digixx/VHF-UHF-Modul-Board/README.md

# VHF-UHF-Modul-Board

This board helps to use SA8x8 VHF/UHF transceiver modules in any projects. It supports an adjustable MIC-Amp and Speaker-Amp. You can choose between a classic microphone or digital output of an mikrocontroller. It is 5V friendly and has LEDs for most signals.
