digixx/VHF-UHF-Modul-Board/production/v1.1/components.png

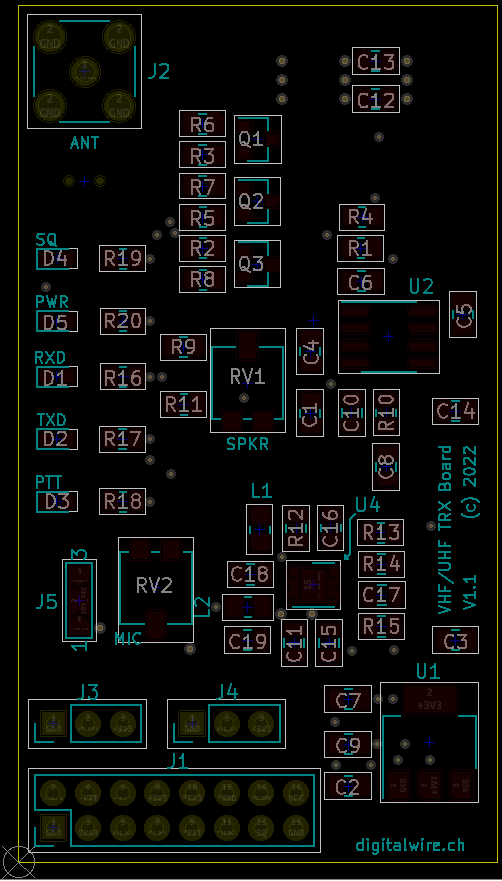
production/v1.1/components.png
