digixx/VHF-UHF-Modul-Board/production/v1.1/schemata.pdf

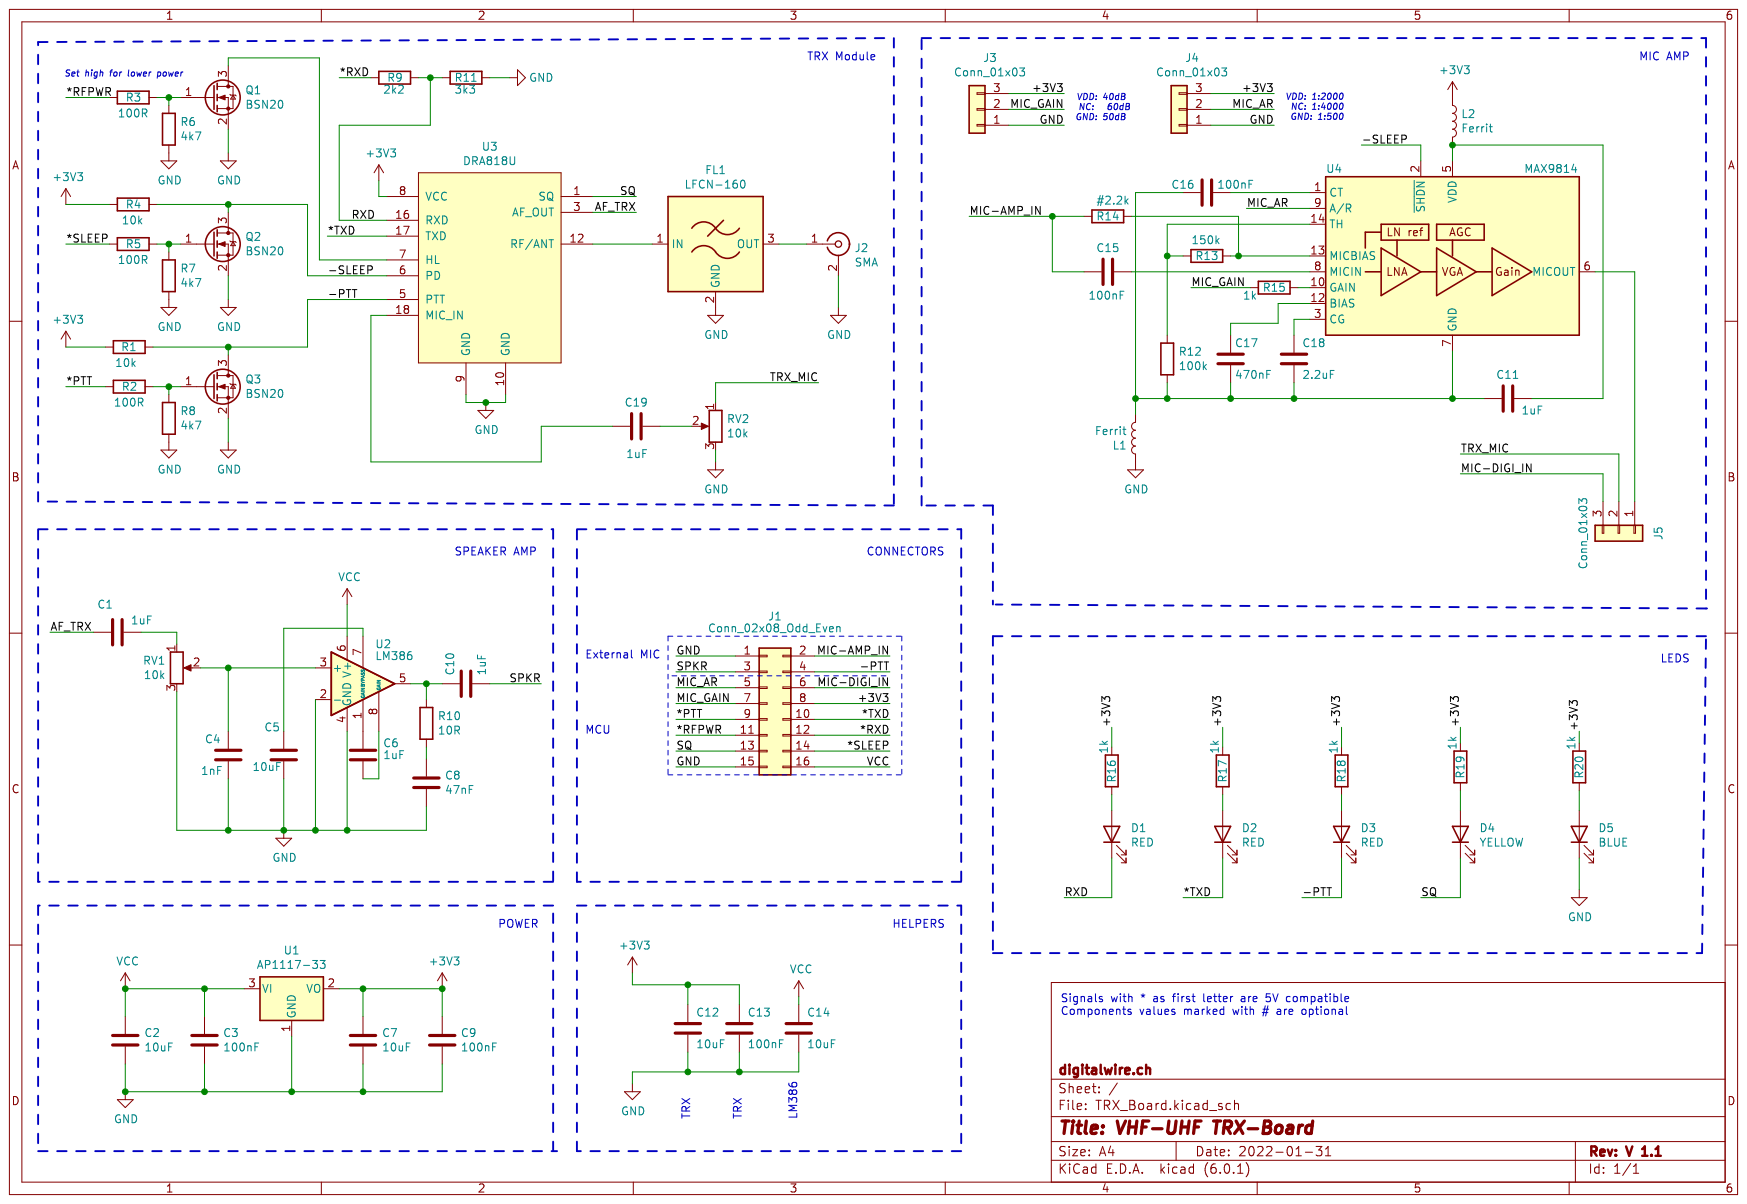
[picture p2: page 1]
