digixx/VHF-UHF-Modul-Board/production/v1,0a/schemata.pdf

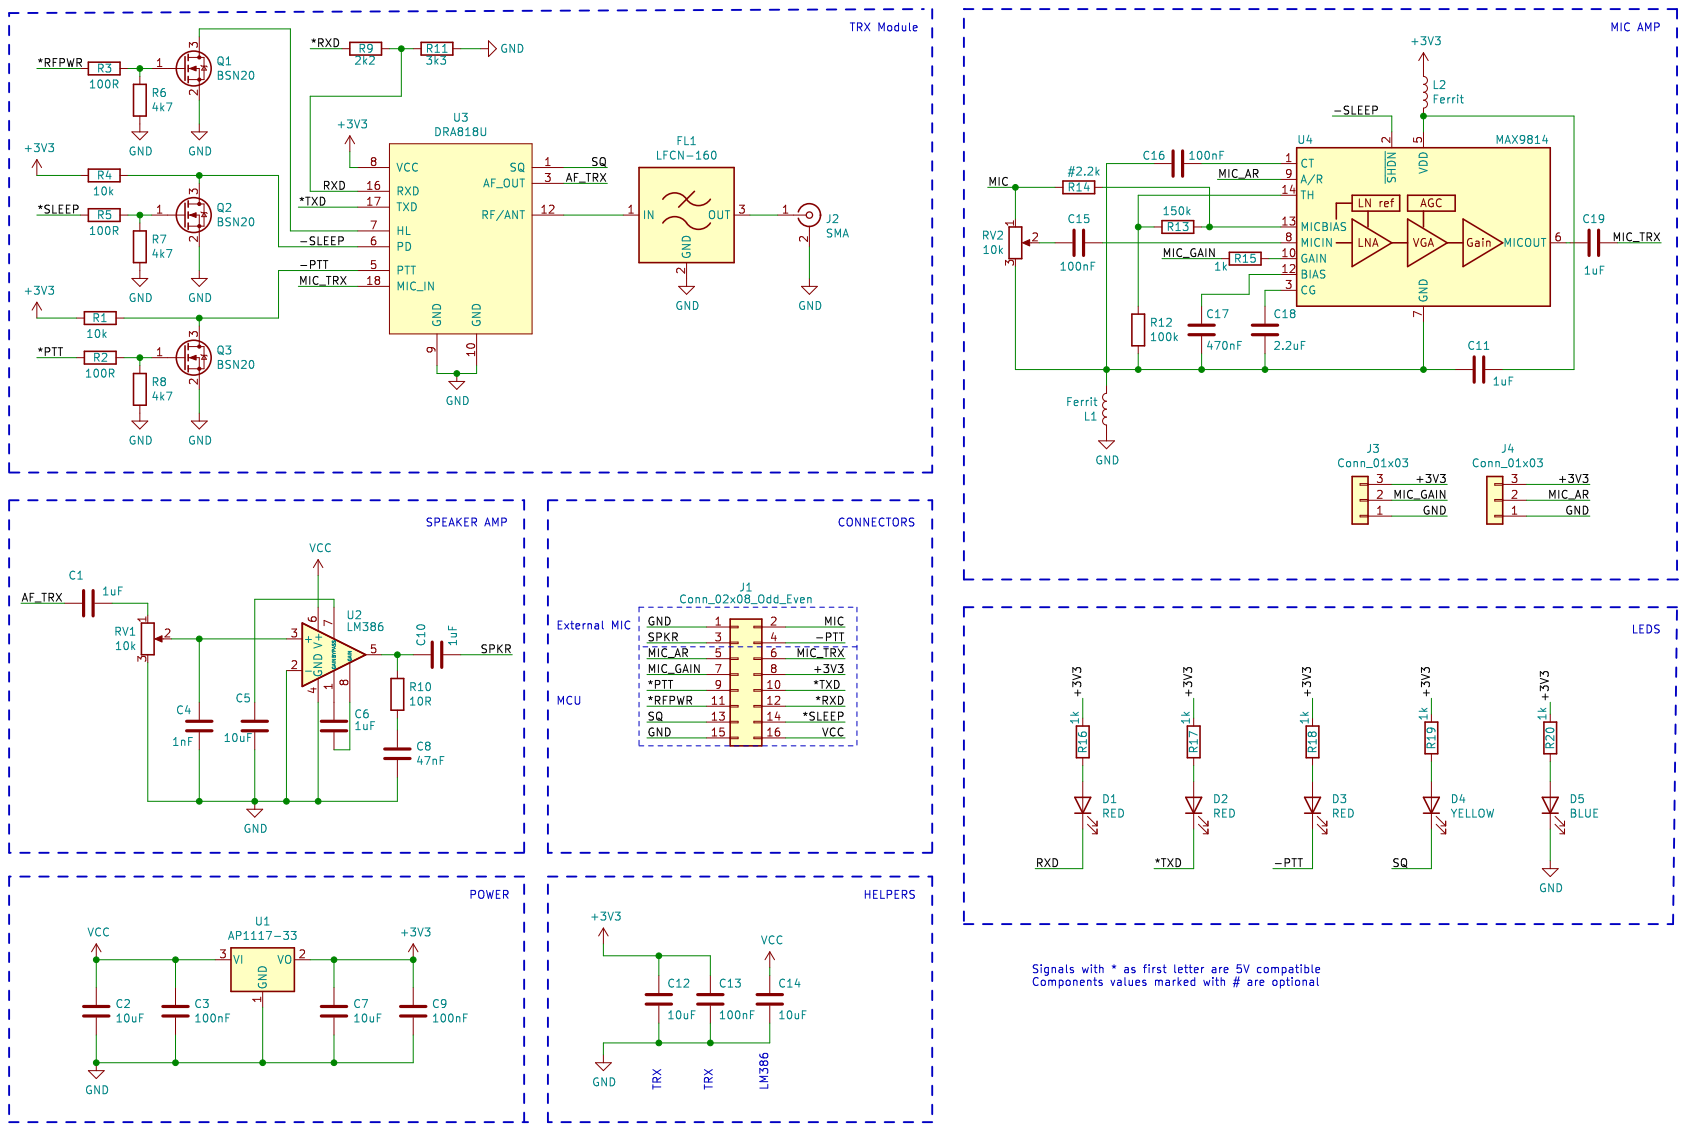
[picture p8: page 1]
