digixx/VHF-UHF-Modul-Board/hardware/TRX_Board.kicad_pcb

## KiCad design hardware/TRX_Board.kicad_pcb (2022-02-01)

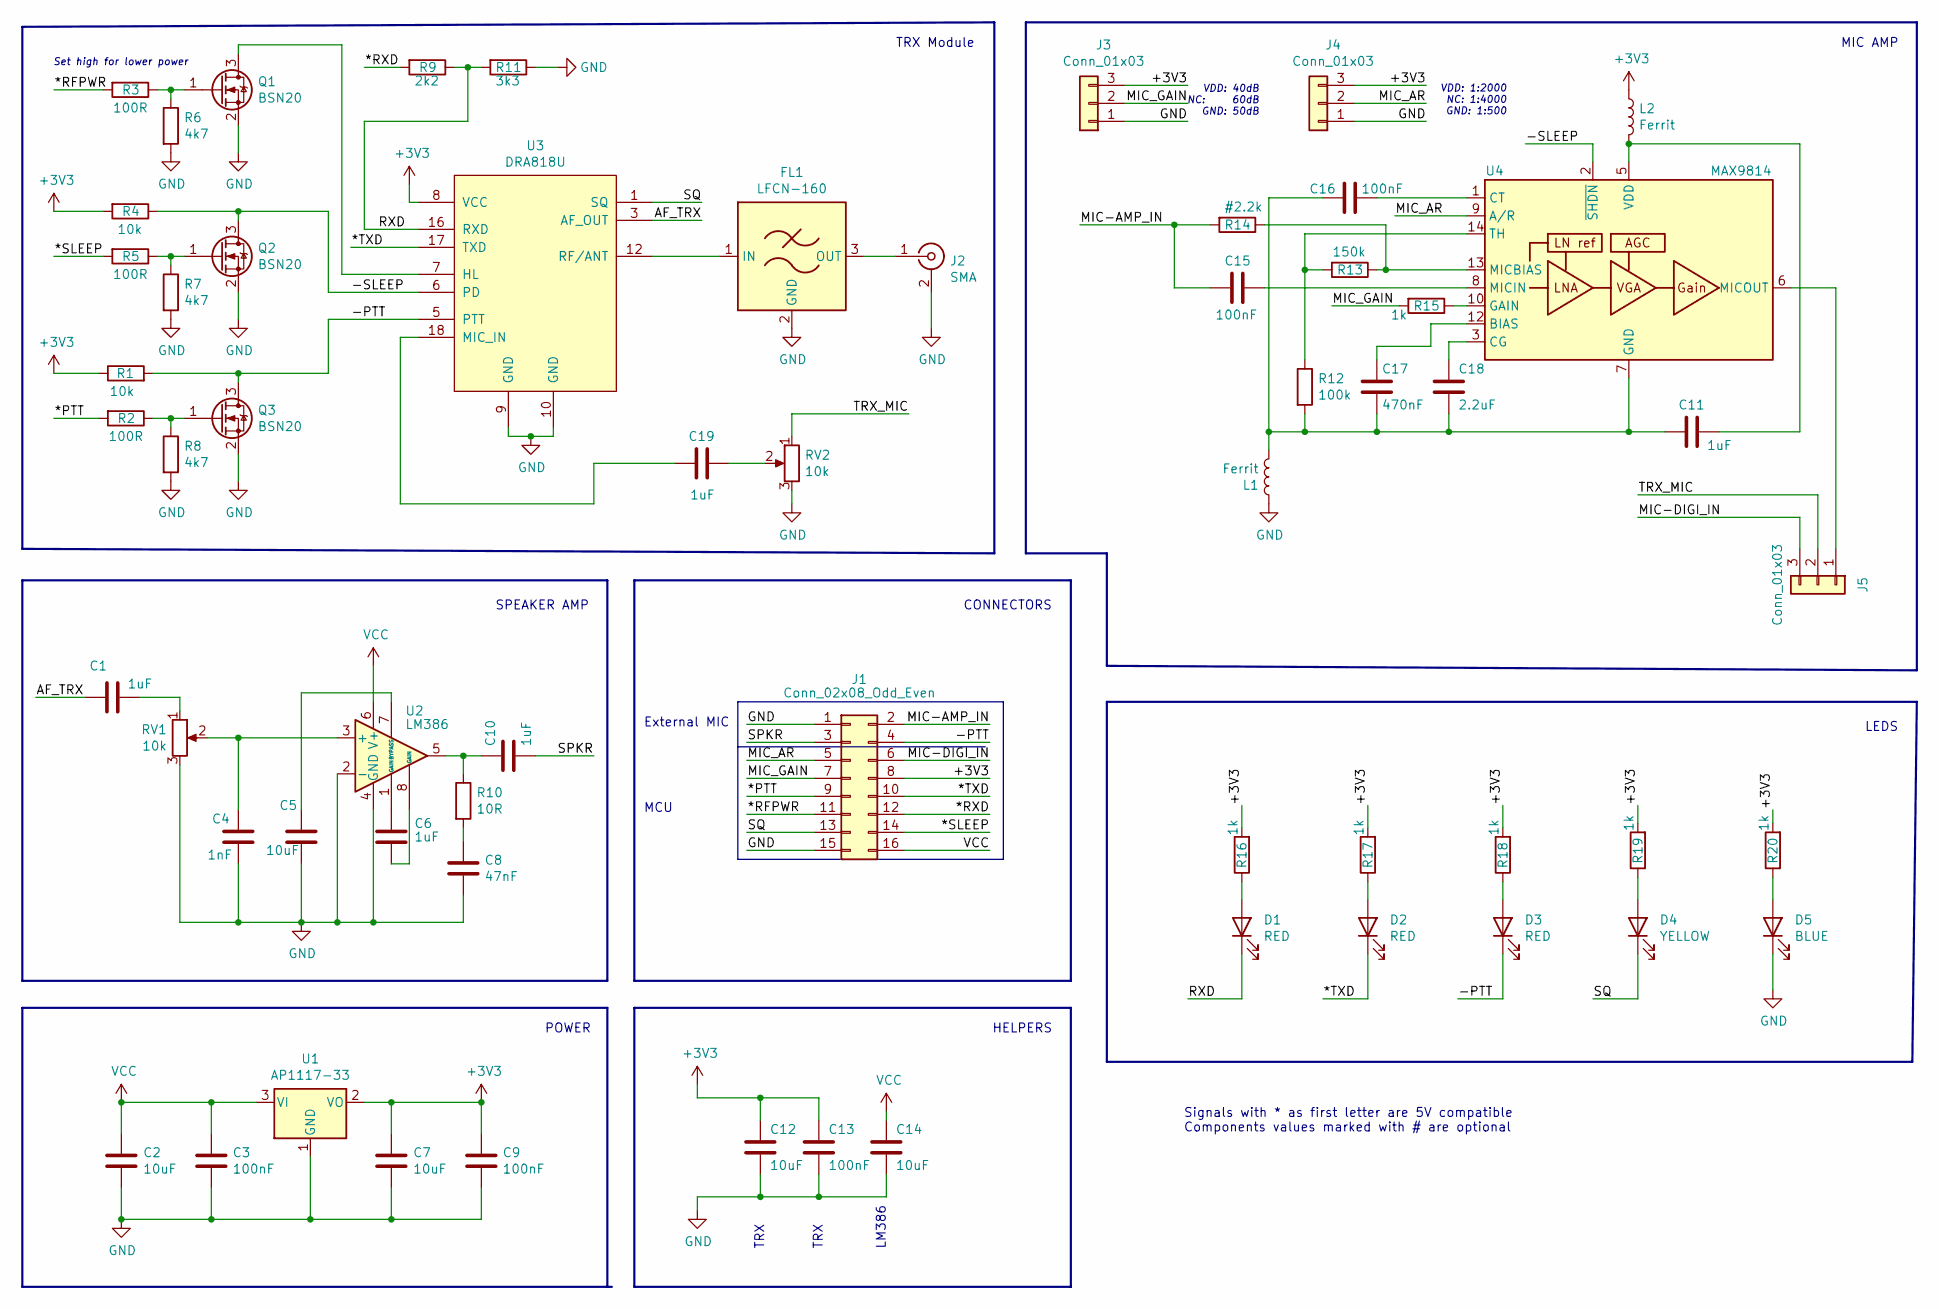
[picture p9: schematic TRX_Board.kicad_sch, VHF-UHF TRX-Board]

Parts:
C1, C6, C10, C11, C19: 1uF; C_0805_2012Metric; LCSC C28323
C2, C5, C7, C12, C14: 10uF; C_0805_2012Metric; LCSC C15850
C3, C9, C13, C15, C16: 100nF; C_0805_2012Metric; LCSC C49678
C4: 1nF; C_0805_2012Metric; LCSC C46653
C8: 47nF; C_0805_2012Metric; LCSC C53134
C17: 470nF; C_0805_2012Metric; LCSC C13967
C18: 2.2uF; C_0805_2012Metric; LCSC C49217
D1, D2, D3: RED; LED_0603_1608Metric; LCSC C2286
D4: YELLOW; LED_0603_1608Metric; LCSC C2296
D5: BLUE; LED_0603_1608Metric; LCSC C12624
FL1: LFCN-160; Filter_Mini-Circuits_FV1206
J1: Conn_02x08_Odd_Even; PinHeader_2x08_P2.54mm_Vertical
J2: SMA; SMA_Amphenol_132134-16_Vertical
J3, J4: Conn_01x03; PinHeader_1x03_P2.54mm_Vertical
J5: Conn_01x03; SolderJumper-3_P2.0mm_Open_TrianglePad1.0x1.5mm_NumberLabels
L1, L2: Ferrit; R_0805_2012Metric_Pad1.20x1.40mm_HandSolder
Q1, Q2, Q3: BSN20; SOT-23; LCSC C20917
R1, R4: 10k; R_0805_2012Metric; LCSC C17414
R2, R3, R5: 100R; R_0805_2012Metric; LCSC C17408
R6, R7, R8: 4k7; R_0805_2012Metric; LCSC C17673
R9: 2k2; R_0805_2012Metric; LCSC C17520
R10: 10R; R_0805_2012Metric; LCSC C17415
R11: 3k3; R_0805_2012Metric; LCSC C26010
R12: 100k; R_0805_2012Metric; LCSC C17407
R13: 150k; R_0805_2012Metric; LCSC C17470
R14: #2.2k; R_0805_2012Metric; LCSC C17520
R15, R16, R17, R18, R19, R20: 1k; R_0805_2012Metric; LCSC C17513
RV1, RV2: 10k; Potentiometer_Vishay_TS53YL_Vertical
U1: AP1117-33; SOT-223-3_TabPin2; LCSC C92517
U2: LM386; SOIC-8_3.9x4.9mm_P1.27mm; LCSC C23573
U3: DRA818U; DRA818
U4: MAX9814; DFN-14-1EP_3x3mm_P0.4mm_EP1.78x2.35mm; LCSC C41714

Connections:
+3V3: C7.1, C9.1, C12.1, C13.1, J1.8, J3.3, J4.3, L2.1, R1.1, R4.2, R16.2, R17.2, R18.2, R19.2, R20.2, U1.2 (VO), U3.8 (VCC)
/*PTT: J1.9, R2.2
/*RFPWR: J1.11, R3.2
/*RXD: J1.12, R9.2
/*SLEEP: J1.14, R5.2
/*TXD: D2.1 (K), J1.10, U3.17 (TXD)
/-PTT: D3.1 (K), J1.4, Q3.3 (D), R1.2, U3.5 (PTT)
/-SLEEP: Q2.3 (D), R4.1, U3.6 (PD), U4.2 (~SHDN)
/AF_TRX: C1.1, U3.3 (AF_OUT)
/MIC-AMP_IN: C15.2, J1.2, R14.2
/MIC-DIGI_IN: J1.6, J5.3
/MIC_AR: J1.5, J4.2, U4.9 (A/R)
/MIC_GAIN: J1.7, J3.2, R15.2
/RXD: D1.1 (K), R9.1, R11.2, U3.16 (RXD)
/SPKR: C10.2, J1.3
/SQ: D4.1 (K), J1.13, U3.1 (SQ)
/TRX_MIC: J5.2, RV2.1
GND: C2.2, C3.2, C4.2, C5.2, C7.2, C8.2, C9.2, C12.2, C13.2, C14.2, D5.1 (K), FL1.2 (GND), FL1.4 (GND), J1.1, J1.15, J2.2 (Ext), J3.1, J4.1, L1.1, Q1.2 (S), Q2.2 (S), Q3.2 (S), R6.2, R7.2, R8.2, R11.1, RV1.3, RV2.3, U1.1 (GND), U2.2 (-), U2.4 (GND), U3.9 (GND), U3.10 (GND)
unnamed: C1.2, RV1.1
unnamed: C4.1, RV1.2, U2.3 (+)
unnamed: C5.1, U2.7 (BYPASS)
unnamed: C6.1, U2.1 (GAIN)
unnamed: C6.2, U2.8 (GAIN)
unnamed: C8.1, R10.2
unnamed: C10.1, R10.1, U2.5
unnamed: C11.1, C16.1, C17.2, C18.2, L1.2, R12.2, U4.4 (GND), U4.7 (GND), U4.11 (GND), U4.15 (GND)
unnamed: C11.2, L2.2, U4.5 (VDD)
unnamed: C15.1, U4.8 (MICIN)
unnamed: C16.2, U4.1 (CT)
unnamed: C17.1, U4.12 (BIAS)
unnamed: C18.1, U4.3 (CG)
unnamed: C19.1, U3.18 (MIC_IN)
unnamed: C19.2, RV2.2
unnamed: D1.2 (A), R16.1
unnamed: D2.2 (A), R17.1
unnamed: D3.2 (A), R18.1
unnamed: D4.2 (A), R19.1
unnamed: D5.2 (A), R20.1
unnamed: FL1.1 (IN), U3.12 (RF/ANT)
unnamed: FL1.3 (OUT), J2.1 (In)
unnamed: Q1.1 (G), R3.1, R6.1
unnamed: Q1.3 (D), U3.7 (HL)
unnamed: Q2.1 (G), R5.1, R7.1
unnamed: Q3.1 (G), R2.1, R8.1
unnamed: R12.1, R13.2, U4.14 (TH)
unnamed: R13.1, R14.1, U4.13 (MICBIAS)
unnamed: R15.1, U4.10 (GAIN)
unnamed: J5.1, U4.6 (MICOUT)
VCC: C2.1, C3.1, C14.1, J1.16, U1.3 (VI), U2.6 (V+)

Notes on the sheet:
LEDS
VDD: 1:2000 NC: 1:4000 GND: 1:500
TRX Module
VDD: 40dB NC: 60dB GND: 50dB
External MIC
CONNECTORS
MCU
POWER
SPEAKER AMP
LM386
Set high for lower power
MIC AMP
TRX
Signals with * as first letter are 5V compatible Components values marked with # are optional
HELPERS

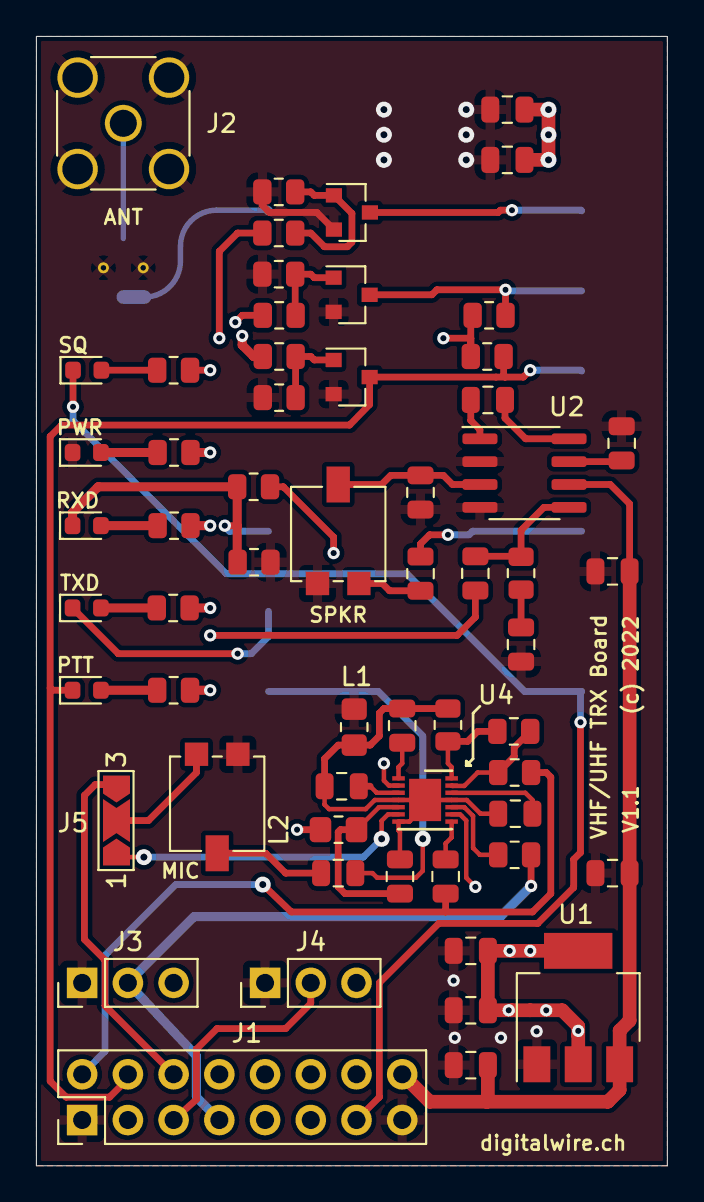
[picture p10: board TRX_Board.kicad_pcb from above]

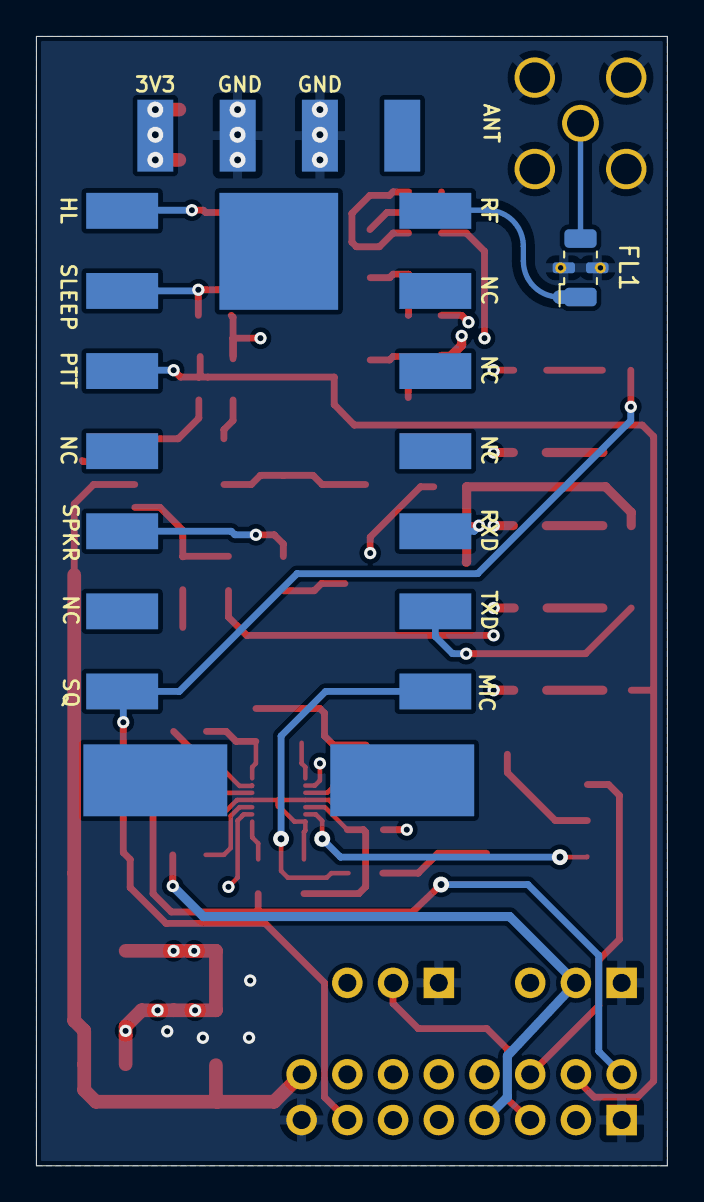
[picture p11: board TRX_Board.kicad_pcb from below]

Board: 4 copper layers, 35.1 x 62.7 mm, 61 parts (2 on the bottom side), 49 nets.
