digixx/VHF-UHF-Modul-Board/(commit log)

2021-12-26 Upgraded to KiCad V6, rearanged some parts, added silkscreen
    [TRX_Board-B_Mask.gbs, TRX_Board-B_Paste.gbp, TRX_Board-B_Silkscreen.gbo, TRX_Board-Back.gbl, TRX_Board-Edge_Cuts.gm1, TRX_Board-F_Mask.gts, TRX_Board-F_Paste.gtp, TRX_Board-F_Silkscreen.gto]
2021-12-26 Changed page information
    [TRX_Board.kicad_pcb, TRX_Board.kicad_sch]
2021-12-26 added schemata and pcb as PDFs
2022-01-30 New folder arrangement for better team working
    [TRX_Board-B_Mask.gbs, TRX_Board-B_Paste.gbp, TRX_Board-B_Silkscreen.gbo, TRX_Board-Back.gbl, TRX_Board-Edge_Cuts.gm1, TRX_Board-F_Mask.gts, TRX_Board-F_Paste.gtp, TRX_Board-F_Silkscreen.gto]
2022-01-30 updated schematic for better mic support / added documents
    [TRX_Board.kicad_sch]
2022-01-31 Optimized MIC path for electret and digital sources / added separated dirs for Gerbers
    [TRX_Board-B_Mask.gbs, TRX_Board-B_Paste.gbp, TRX_Board-B_Silkscreen.gbo, TRX_Board-Back.gbl, TRX_Board-Edge_Cuts.gm1, TRX_Board-F_Mask.gts, TRX_Board-F_Paste.gtp, TRX_Board-F_Silkscreen.gto]
2022-01-31 new Gerbers for V1.1
    [TRX_Board-B_Mask.gbs, TRX_Board-B_Paste.gbp, TRX_Board-B_Silkscreen.gbo, TRX_Board-Back.gbl, TRX_Board-Edge_Cuts.gm1, TRX_Board-F_Mask.gts, TRX_Board-F_Paste.gtp, TRX_Board-F_Silkscreen.gto]
2022-01-31 added schemata,pdf
    [TRX_Board.kicad_sch]
2022-02-01 Changed traces to antenna to 50 ohms
    [TRX_Board.kicad_pcb]
2022-02-28 Added missing parts sources
    [TRX_Board.kicad_sch]
2022-04-15 Add modified BOM with categorized sections and updated part numbers
    [TRX_Board.xlsx]
2022-04-15 add 'sep=;' to csv file so that it can load properly in excel
    [TRX_Board.csv]
