digixx/VHF-UHF-Modul-Board/(notices)

Notices in the files:
hardware/TRX_Board.kicad_pcb:
(c) 2022
